Jayanth-M0625/MRL/moteus-mod-n1/moteus-mod-n1.kicad_pcb

## KiCad design moteus-mod-n1/moteus-mod-n1.kicad_pcb (2025-11-13)

Schematic: moteus-mod-n1.kicad_sch

Parts:
A1: PAD16AWG_TERM; 16AWG_TERMcustom
B1: PAD16AWG_TERM; 16AWG_TERMcustom
C1, C3, C6, C10, C33, C46, C47, C53, C64, C70, C72: 0.1uF; C0402; MPN MF-CAP-0402-0.1uF
C2: 0.47uF 100V; C0805; MPN 08051C474KAT2A
C4, C7: 0.1uF 100V; C0603; MPN GCJ188R72A104KA01D
C5, C8: 1uF; C0603; MPN C1608X7R1E105K080AE
C9: DNP; C0402
C11, C16, C21, C57: 1uF; C0402; MPN MF-CAP-0402-1uF
C12: 1uF 100V; C0805; MPN GCM21BC72A105KE36L
C13: 1uF; C0603; MPN MF-CAP-0603-1uF
C14, C17, C19: 0.1uF 100V; C1206; MPN 12061C104KAT2A
C15: 22uF; C1206; MPN GRM31CR71A226KE15L
C18: PAD16AWG_TERM; 16AWG_TERMcustom
C20: 22uF; C1206; MPN CL31B226KPHNNNE
C22, C23, C24, C25, C26, C27, C28, C29, C30, C31, C34, C35, C36, C37, C38, C39, C40, C41, C43, C44, C45, C48, C49, C50, C54, C55, C56, C58, C59, C60, C61, C62, C63, C65, C66, C67, C69, C71, C76, C77, C78, C79, C80, C81, C82, C83, C84, C85: 4.7uF 100V; C1206_NOBORDER; MPN GRJ31CC72A475KE01K
C32: 0.01uF; C0402; MPN MF-CAP-0402-0.01uF
C42, C51: 4.7uF 100V; C1206; MPN GRJ31CC72A475KE01K
C52: 4.7uF; C0603; MPN CL10A475KP8NNNC
C68: 10uF; C1206; MPN MF-CAP-1206-10uF
C73, C74, C75: 1000pF; C0402; MPN MF-CAP-0402-1nF
CAN1, CAN2, CAN3: 1X3
D1, D2, D3, D4, D5, D6, D7, D8, D9: BAT41KFILM; SODFL1608X70N; MPN BAT41KFILM
D10: MF-LED-0603-RED; LED0603
D11: MF-LED-0603-RED; LED0603; MPN MF-LED-0603-GREEN
D12: DIODE-DO214AA; DO214AA; MPN SMBJ51D-M3/I
D13, D14: PAD24AWG_PAD; 24AWG_PAD
DAC1: PAD24AWG_PAD; 24AWG_PAD
DG1: PAD24AWG_PAD; 24AWG_PAD
L1: SRN4018-220M; IND_BOURNS_SRN4018; MANUFACTURER_PART_NUMBER 74404042470
L2: 74479887222A; IND_1008_WE-PMI_WRE; MPN 74479887222A
M1, M2, M3: MOUNT; M2.5MOUNT
Q1, Q3, Q5: TPH1R204PL_VIAS; SOP_ADVANCE_8_VIAS; MPN TPH2R408QM,L1Q
Q2, Q4, Q6: TPH1R204PLSOP_ADVANCE_8; SOP_ADVANCE_8; MPN TPH2R408QM,L1Q
R1, R2: 2k; R0402; MPN MF-RES-0402-2K
R3, R8, R13: 0; R0402; MPN MF-RES-0402-0
R4, R17: DNP; R0402
R5: DNP; R0805
R6, R7, R10, R11, R12: 7.5; R0402; MPN RC0402FR-077R5L
R9: 7.5; R0805; MPN RC0805FR-077R5L
R14, R16: 100k 1%; R0402; MPN RC0402FR-07100KL
R15: 4.7k 1%; R0402; MPN RC0402FR-074K7L
R18, R21: 560; R0402; MPN MF-RES-0402-560
R19: 47k NTC; R0402; MPN NCP15WB473F03RC
R20, R22: 10k 1%; R0402; MPN RC0402FR-0710KL
R23, R24, R25: 22; R0402; MPN MF-RES-0402-22
RA1: 0.5mOhm 1% 2W; M1206; MPN HCS1206FTL500
RB1: 0.5mOhm 1% 2W; M1206; MPN HCS1206FTL500
RC1: 0.5mOhm 1% 2W; M1206; MPN HCS1206FTL500
SH1: SHORTMEDIUM; SHORT_TOP-MEDIUM
SH2, SH3, SH4: SHORTT5; SHORT_TOP-50
SWD1: JST-ZH6; JST_S6B-ZR-SM4A-TF(LF)(SN); MPN S6B-ZR-SM4A-TF(LF)(SN)
TEMP1: 1X2
U1: TCAN1042HGV; SOIC8; MPN TCAN1057AEVDRQ1
U2: AS5147; TSSOP14; MPN AS5047P-ATSM
U3: DRV8353S; WQFN-40; MPN DRV8353FSRTAR
U4: MAX15062AATA+T; 21-0487A_MXM; MANUFACTURER_PART_NUMBER MAX15062BATA+T
U5: ADP5301ACBZ-4-R7; BGA9C50P3X3_165X187X66; MPN ADP5301ACBZ-4-R7
U6: STM32G474CEU6; QFN50P700X700X60-49N; MPN STM32G474CEU6
VN1: PAD16AWG_TERM; 16AWG_TERMcustom
VP1: PAD16AWG_TERM; 16AWG_TERMcustom

Connections:
+3V3: C3.P$1, C6.P$2, C10.P$1, C20.P$1, C21.P$1, C46.P$1, C47.P$1, C52.P$1, C57.P$1, C64.P$1, C68.P$2, C70.P$1, D14.P$1, L2.1, R1.P$1, R2.P$1, R3.P$2, R16.P$2, R18.P$1, R19.P$1, R21.P$1, SWD1.6, TEMP1.1, U1.5 (VIO), U2.12 (VDD3V), U3.24 (VREF), U5.C2 (FB), U6.1 (VBAT), U6.20 (VREF+), U6.21 (VDDA), U6.23 (VDD_1), U6.35 (VDD_2), U6.48 (VDD_3)
+5V: C1.P$1, C15.P$1, C16.P$1, D13.P$1, L1.1, R13.P$2, U1.3 (VCC), U4.4 (FB/VOUT), U5.A2 (PVIN), U5.A3 (EN)
/AS5047_CS: U2.1 (CS/), U6.19 (PB2)
/AUX1_A: U2.2 (CLK), U6.13 (PA5), U6.27 (PB14)
/AUX1_B: U2.3 (MISO), U6.42 (PB4)
/AUX1_C: U2.4 (MOSI), U6.15 (PA7)
/CAN_N: CAN1.2, CAN2.2, CAN3.2, R5.P$2, U1.6 (CANL)
/CAN_P: CAN1.1, CAN2.1, CAN3.1, R5.P$1, U1.7 (CANH)
/CAN_RX: U1.4 (RXD), U6.43 (PB5)
/CAN_TX: U1.1 (TXD), U6.44 (PB6)
/CUR1: R23.P$1, U3.23 (SOA)
/CUR2: R24.P$1, U3.22 (SOB)
/CUR3: R25.P$1, U3.21 (SOC)
/DAC: DAC1.P$1, R16.P$1, R17.P$2, U6.12 (PA4)
/DRV8323_CS: U3.30 (CS), U6.17 (PB0)
/DRV8323_MISO: R1.P$2, U3.27 (MISO), U6.40 (PC11)
/DRV8323_MOSI: U3.28 (MOSI), U6.2 (PC13)
/DRV8323_SCLK: U3.29 (SCLK), U6.39 (PC10)
/FCUR1: C73.P$1, R23.P$2, U6.11 (PA3)
/FCUR2: C74.P$1, R24.P$2, U6.14 (PA6)
/FCUR3: C75.P$1, R25.P$2, U6.18 (PB1)
/GHA: D2.1 (K), R7.P$1, U3.6 (GHA)
/GHA_D: D2.2 (A), Q1.4 (G), R7.P$2
/GHB: D5.1 (K), R10.P$1, U3.15 (GHB)
/GHB_D: D5.2 (A), Q3.4 (G), R10.P$2
/GHC: D7.1 (K), R12.P$1, U3.16 (GHC)
/GHC_D: D7.2 (A), Q5.4 (G), R12.P$2
/GLA: D1.1 (K), R6.P$1, U3.8 (GLA)
/GLA_D: D1.2 (A), D3.1 (K), Q2.4 (G), R6.P$2
/GLB: D4.1 (K), R9.P$1, U3.13 (GLB)
/GLB_D: D4.2 (A), D6.1 (K), Q4.4 (G), R9.P$2
/GLC: D8.1 (K), R11.P$1, U3.18 (GLC)
/GLC_D: D8.2 (A), D9.1 (K), Q6.4 (G), R11.P$2
/LED1: D10.CATHODE, U6.28 (PB15)
/LED2: D11.CATHODE, U6.29 (PC6)
/MOTOR1: U3.32 (INHA), U6.8 (PA0)
/MOTOR2: U3.34 (INHB), U6.9 (PA1)
/MOTOR3: U3.36 (INHC), U6.10 (PA2)
/MOTOR_ENABLE: U3.31 (ENABLE), U6.3 (PC14-OSC32_IN)
/MOTOR_FAULT: R2.P$2, U3.26 (FAULT), U6.26 (PB13)
/MOTOR_HIZ: U3.33 (INLA), U3.35 (INLB), U3.37 (INLC), U6.4 (PC15-OSC32_OUT)
/NRST: C33.P$1, SWD1.2, U6.7 (PG10-NRST)
/SHA: A1.1, A1.2, A1.3, A1.4, A1.5, A1.6, A1.7, A1.8, A1.9, A1.10, A1.11, A1.12, A1.13, Q1.1 (S), Q1.2 (S), Q1.3 (S), Q2.5 (D), Q2.6 (D), Q2.7 (D), Q2.8 (D), Q2.PAD (D), U3.7 (SHA)
/SHB: B1.1, B1.2, B1.3, B1.4, B1.5, B1.6, B1.7, B1.8, B1.9, B1.10, B1.11, B1.12, B1.13, Q3.1 (S), Q3.2 (S), Q3.3 (S), Q4.5 (D), Q4.6 (D), Q4.7 (D), Q4.8 (D), Q4.PAD (D), U3.14 (SHB)
/SHC: C18.1, C18.2, C18.3, C18.4, C18.5, C18.6, C18.7, C18.8, C18.9, C18.10, C18.11, C18.12, C18.13, Q5.1 (S), Q5.2 (S), Q5.3 (S), Q6.5 (D), Q6.6 (D), Q6.7 (D), Q6.8 (D), Q6.PAD (D), U3.17 (SHC)
/SWCLK: SWD1.5, U6.37 (PA14)
/SWDIO: SWD1.3, U6.36 (PA13)
/SXA_N: SH2.1, U3.10 (SNA)
/SXA_P: C14.P$2, Q2.1 (S), Q2.2 (S), Q2.3 (S), RA1.2, U3.9 (SPA)
/SXB_N: SH3.1, U3.11 (SNB)
/SXB_P: C17.P$2, Q4.1 (S), Q4.2 (S), Q4.3 (S), RB1.2, U3.12 (SPB)
/SXC_N: SH4.1, U3.20 (SNC)
/SXC_P: C19.P$2, Q6.1 (S), Q6.2 (S), Q6.3 (S), RC1.2, U3.19 (SPC)
/VBAT_SENSE: C32.P$1, R14.P$1, R15.P$2, U6.31 (PA9)
/VSW: L1.2, U4.8 (LX)
/VTEMP_FET: C53.P$1, R19.P$2, R20.P$1, U6.25 (PB12)
/VTEMP_MOT: C72.P$1, R22.P$1, TEMP1.2, U6.30 (PA8)
unnamed: C9.P$1, M3.P$1, R4.P$1
unnamed: D10.ANODE, R18.P$2
unnamed: D11.ANODE, R21.P$2
unnamed: R3.P$1, U2.11 (VDD5V)
unnamed: C7.P$1, U3.2 (CPH)
unnamed: C7.P$2, U3.1 (CPL)
unnamed: C11.P$2, U3.38 (DVDD)
unnamed: C5.P$2, U3.5 (VCP)
unnamed: C8.P$2, U3.40 (VGLS)
unnamed: R8.P$2, U4.5 (MODE)
unnamed: C13.P$1, U4.3 (VCC)
unnamed: L2.2, U5.A1 (SW)
unnamed: R13.P$1, U5.B3 (SYNC/_MODE)
V+: C2.P$1, C4.P$1, C5.P$1, C12.P$1, C14.P$1, C17.P$1, C19.P$1, C22.P$1, C23.P$1, C24.P$1, C25.P$1, C26.P$1, C27.P$1, C28.P$1, C29.P$1, C30.P$1, C31.P$1, C34.P$1, C35.P$1, C36.P$1, C37.P$1, C38.P$1, C39.P$1, C40.P$1, C41.P$1, C42.P$1, C43.P$1, C44.P$1, C45.P$1, C48.P$1, C49.P$1, C50.P$1, C51.P$1, C54.P$1, C55.P$1, C56.P$1, C58.P$1, C59.P$1, C60.P$1, C61.P$1, C62.P$1, C63.P$1, C65.P$1, C66.P$1, C67.P$1, C69.P$1, C71.P$1, C76.P$1, C77.P$1, C78.P$1, C79.P$1, C80.P$1, C81.P$1, C82.P$1, C83.P$1, C84.P$1, C85.P$1, D12.C, Q1.5 (D), Q1.6 (D), Q1.7 (D), Q1.8 (D), Q1.PAD (D), Q3.5 (D), Q3.6 (D), Q3.7 (D), Q3.8 (D), Q3.PAD (D), Q5.5 (D), Q5.6 (D), Q5.7 (D), Q5.8 (D), Q5.PAD (D), R14.P$2, U3.3 (VM), U3.4 (VDRAIN), U4.1 (VIN), U4.2 (EN/UVLO), VP1.1, VP1.2, VP1.3, VP1.4, VP1.5, VP1.6, VP1.7, VP1.8, VP1.9, VP1.10, VP1.11, VP1.12, VP1.13

Notes on the sheet:
check component placement
POWER INPUT AND MOUNTING
CAN_L = CAN_N
OPTIONAL 120 TERMINATION RESISTOR
Need to connect either PA5 or PB14. Decide which one
BULK DC CAPS
MICROCONTROLLER
CAN_H = CAN_P
POWER STAGE
GATE DRIVER
Added 10 more DC Caps
NTC: Temperature sensing - keep near MOSFETs
Rotary encoder
This is where GND and V- are shorted
check how to connect this
CAN / ENCODER
check placement
This stage converts V+ into 5V and 3.3V
DEBUG
EXTERNAL CONNECTORS
PCB rev divider HI / LO r1.1/r1.2 - open / 100k r1.3 - 100k / open
REGULATORS
SENSE / LED

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
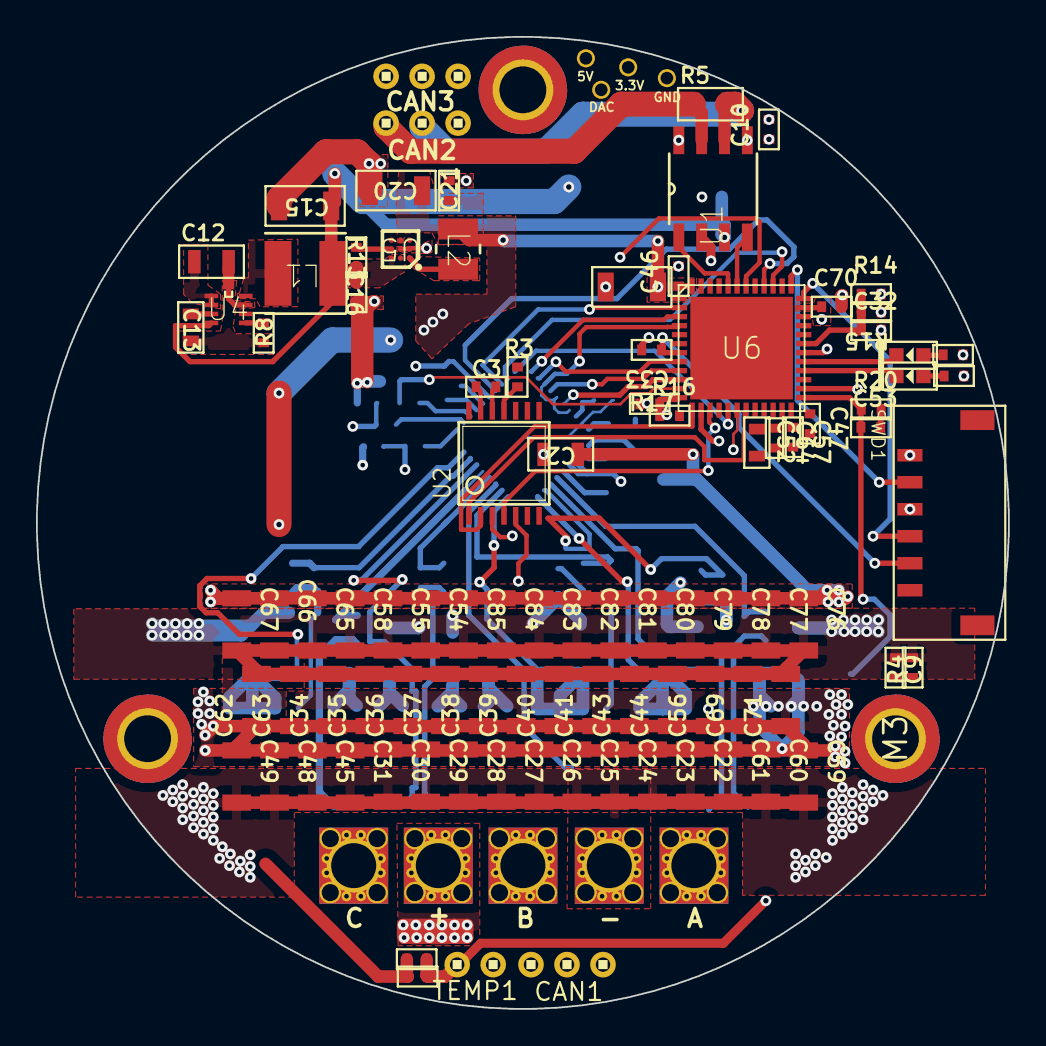
[picture p1: board moteus-mod-n1.kicad_pcb from above]

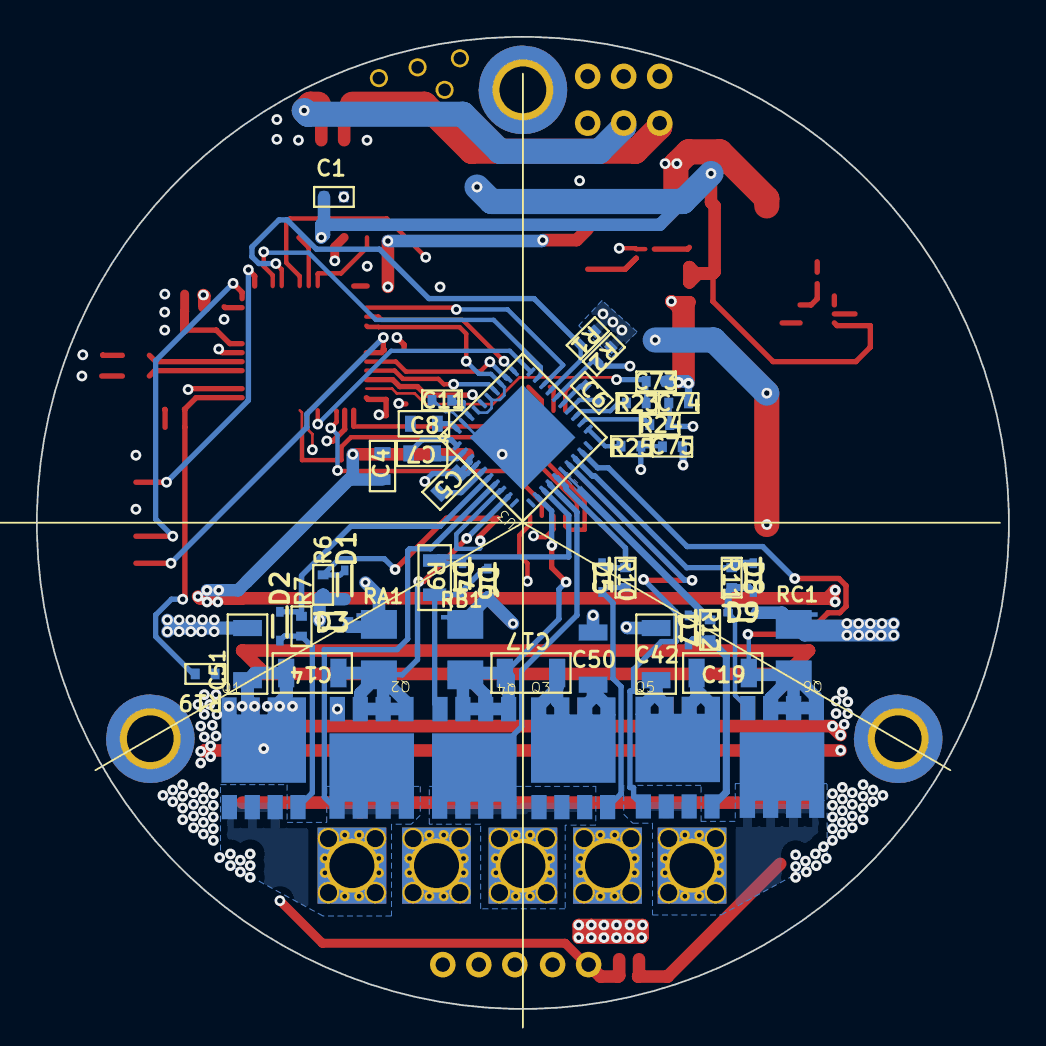
[picture p2: board moteus-mod-n1.kicad_pcb from below]

Board: 4 copper layers, 54.0 x 54.0 mm, 158 parts (50 on the bottom side), 73 nets.
