Jayanth-M0625/MRL/stm32g474/stm32g474.kicad_pcb

## KiCad design stm32g474/stm32g474.kicad_pcb (2025-10-17)

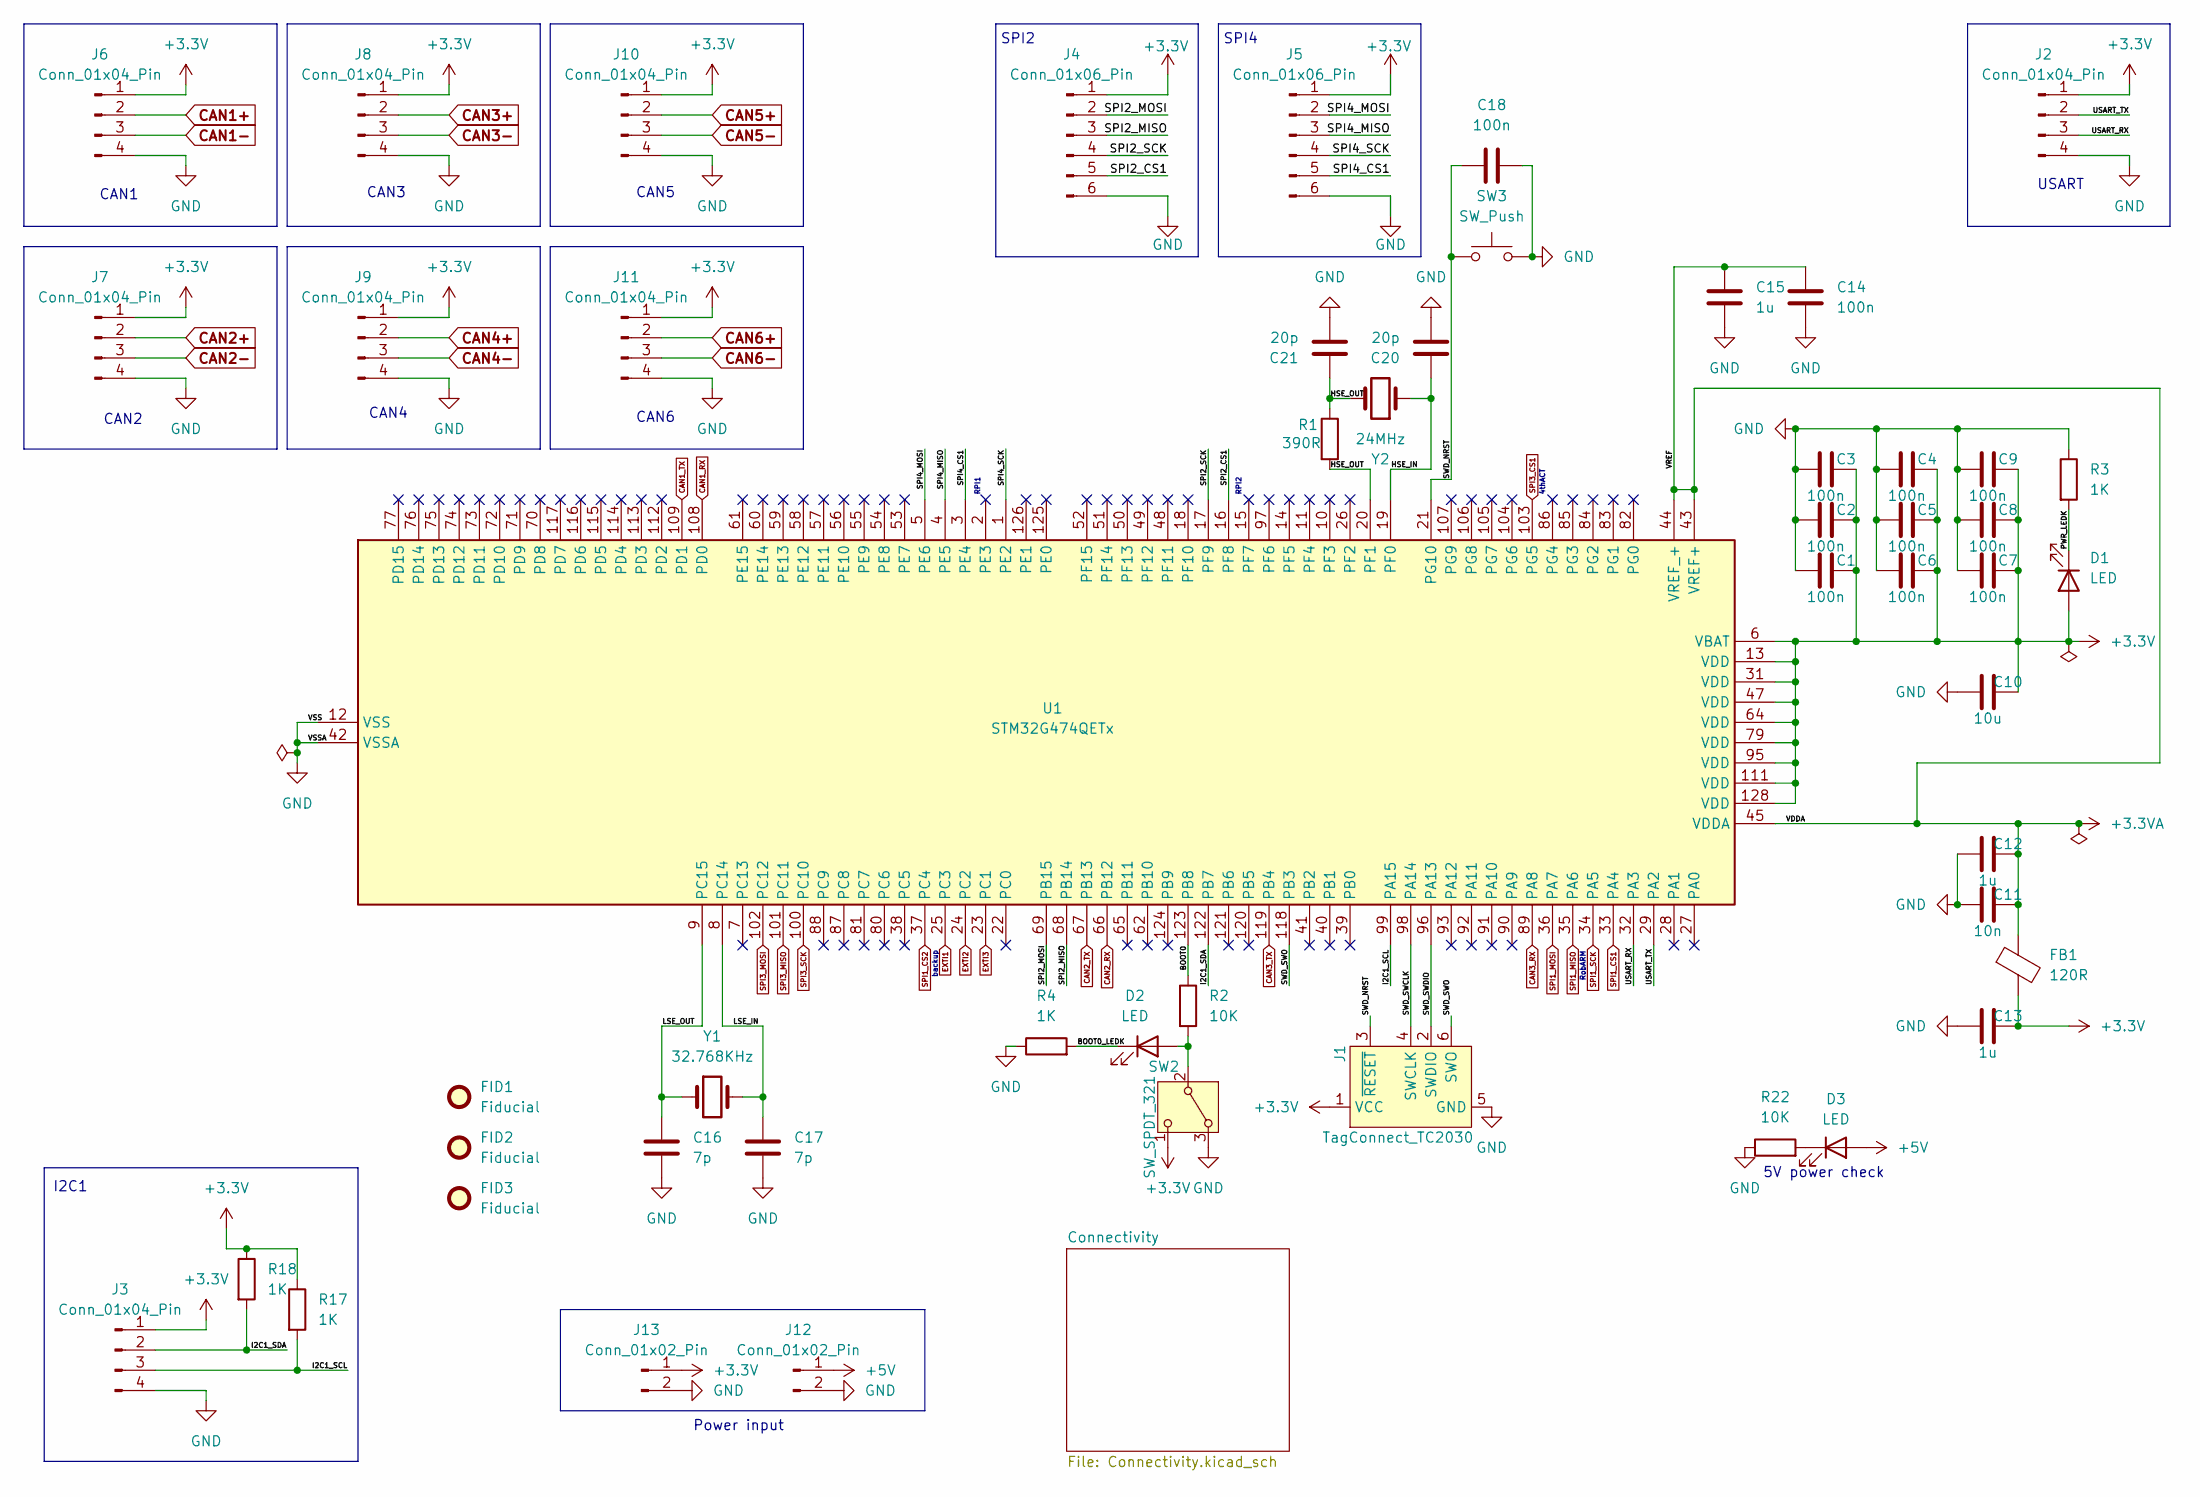
[picture p3: schematic stm32g474.kicad_sch]

Parts:
C1, C2, C3, C4, C5, C6, C7, C8, C9, C14, C18: 100n; C_0402_1005Metric; Manufacturer Part Number 0402ZC104MAT2A
C10: 10u; C_0805_2012Metric; Manufacturer Part Number C0805C106K8PAC
C11: 10n; C_0402_1005Metric
C12, C13, C15: 1u; C_0402_1005Metric
C16, C17: 7p; C_0402_1005Metric
C20, C21: 20p; C_0402_1005Metric
D1, D2, D3: LED; LED_0402_1005Metric
FB1: 120R; L_0603_1608Metric
FID1, FID2, FID3: Fiducial; Fiducial_0.5mm_Mask1.5mm
J1: TagConnect_TC2030; Tag-Connect_TC2030-IDC-FP_2x03_P1.27mm_Vertical
J2, J3, J6, J7, J8, J9, J10, J11: Conn_01x04_Pin; PinHeader_1x04_P2.54mm_Vertical
J4, J5: Conn_01x06_Pin; PinHeader_1x06_P2.54mm_Horizontal
J12, J13: Conn_01x02_Pin; PinHeader_1x02_P2.54mm_Vertical
R1: 390R; R_0402_1005Metric
R2, R22: 10K; R_0402_1005Metric
R3, R4, R17, R18: 1K; R_0402_1005Metric
SW2: SW_SPDT_321; SW_SPDT_PCM12
SW3: SW_Push; SW_SPST_CK_RS282G05A3
U1: STM32G474QETx; LQFP-128_14x14mm_P0.4mm
Y1: 32.768KHz; Crystal_SMD_3215-2Pin_3.2x1.5mm; Manufacturer Part Number CM7V-T1A-32.768kHz-7pF-10PPM-TA-QC T3
Y2: 24MHz; Crystal_SMD_TXC_7M-4Pin_3.2x2.5mm; Manufacturer Part Number ECS-240-20-33-CKM-TR3

Connections:
+3.3V: C1.1, C2.1, C3.1, C4.1, C5.1, C6.1, C7.1, C8.1, C9.1, C10.1, C13.1, D1.2 (A), FB1.2, J1.1 (VCC), J2.1, J3.1, J4.1, J5.1, J6.1, J7.1, J8.1, J9.1, J10.1, J11.1, J13.1, R17.1, R18.1, SW2.1 (C), U1.6 (VBAT), U1.13 (VDD), U1.31 (VDD), U1.47 (VDD), U1.64 (VDD), U1.79 (VDD), U1.95 (VDD), U1.111 (VDD), U1.128 (VDD); also elsewhere on the board
+3.3VA: C11.1, C12.1, C14.1, C15.1, FB1.1, U1.43 (VREF+), U1.44 (VREF_+), U1.45 (VDDA)
/BOOT0: R2.1, U1.123 (PB8)
/BOOT0_LEDK: D2.1 (K), R4.2
/HSE_IN: C20.1, U1.19 (PF0), Y2.1
/HSE_OUT: C21.1, R1.1, R1.2, U1.20 (PF1), Y2.2
/I2C1_SCL: J3.3, R17.2, U1.99 (PA15)
/I2C1_SDA: J3.2, R18.2, U1.122 (PB7)
/LSE_IN: C17.1, U1.8 (PC14), Y1.2
/LSE_OUT: C16.1, U1.9 (PC15), Y1.1
/PWR_LEDK: D1.1 (K), R3.2
/SPI2_CS1: J4.5, U1.16 (PF8)
/SPI2_MISO: J4.3, U1.68 (PB14)
/SPI2_MOSI: J4.2, U1.69 (PB15)
/SPI2_SCK: J4.4, U1.17 (PF9)
/SPI4_CS1: J5.5, U1.3 (PE4)
/SPI4_MISO: J5.3, U1.4 (PE5)
/SPI4_MOSI: J5.2, U1.5 (PE6)
/SPI4_SCK: J5.4, U1.1 (PE2)
/SWD_NRST: C18.2, J1.3 (~RESET), SW3.1, U1.21 (PG10)
/SWD_SWCLK: J1.4 (SWCLK), U1.98 (PA14)
/SWD_SWDIO: J1.2 (SWDIO), U1.96 (PA13)
/SWD_SWO: J1.6 (SWO), U1.118 (PB3)
/USART_RX: J2.3, U1.32 (PA3)
/USART_TX: J2.2, U1.29 (PA2)
CAN1+: J6.2; also elsewhere on the board
CAN1-: J6.3; also elsewhere on the board
CAN1_RX: U1.108 (PD0); also elsewhere on the board
CAN1_TX: U1.109 (PD1); also elsewhere on the board
CAN2+: J7.2; also elsewhere on the board
CAN2-: J7.3; also elsewhere on the board
CAN2_RX: U1.66 (PB12); also elsewhere on the board
CAN2_TX: U1.67 (PB13); also elsewhere on the board
CAN3+: J8.2; also elsewhere on the board
CAN3-: J8.3; also elsewhere on the board
CAN3_RX: U1.89 (PA8); also elsewhere on the board
CAN3_TX: U1.119 (PB4); also elsewhere on the board
CAN4+: J9.2; also elsewhere on the board
CAN4-: J9.3; also elsewhere on the board
CAN5+: J10.2; also elsewhere on the board
CAN5-: J10.3; also elsewhere on the board
CAN6+: J11.2; also elsewhere on the board
CAN6-: J11.3; also elsewhere on the board
EXTI1: U1.25 (PC3); also elsewhere on the board
EXTI2: U1.24 (PC2); also elsewhere on the board
EXTI3: U1.23 (PC1); also elsewhere on the board
GND: C1.2, C2.2, C3.2, C4.2, C5.2, C6.2, C7.2, C8.2, C9.2, C10.2, C11.2, C12.2, C13.2, C14.2, C15.2, C16.2, C17.2, C18.1, C20.2, C21.2, J1.5 (GND), J2.4, J3.4, J4.6, J5.6, J6.4, J7.4, J8.4, J9.4, J10.4, J11.4, J12.2, J13.2, R3.1, R4.1, R22.1, SW2.3 (A), SW3.2, U1.12 (VSS), U1.30 (VSS), U1.42 (VSSA), U1.46 (VSS), U1.63 (VSS), U1.78 (VSS), U1.94 (VSS), U1.110 (VSS), U1.127 (VSS); also elsewhere on the board
unnamed: D2.2 (A), R2.2, SW2.2 (B)
SPI1_CS1: U1.33 (PA4); also elsewhere on the board
SPI1_CS2: U1.37 (PC4); also elsewhere on the board
SPI1_MISO: U1.35 (PA6); also elsewhere on the board
SPI1_MOSI: U1.36 (PA7); also elsewhere on the board
SPI1_SCK: U1.34 (PA5); also elsewhere on the board
SPI3_CS1: U1.103 (PG5); also elsewhere on the board
SPI3_MISO: U1.101 (PC11); also elsewhere on the board
SPI3_MOSI: U1.102 (PC12); also elsewhere on the board
SPI3_SCK: U1.100 (PC10); also elsewhere on the board

Notes on the sheet:
SPI2
CAN2
RobARM
USART
CAN1
5V power check
RPI1
backup
CAN6
SPI4
4thACT
CAN5
Power input
CAN3
I2C1
RPI2
CAN4

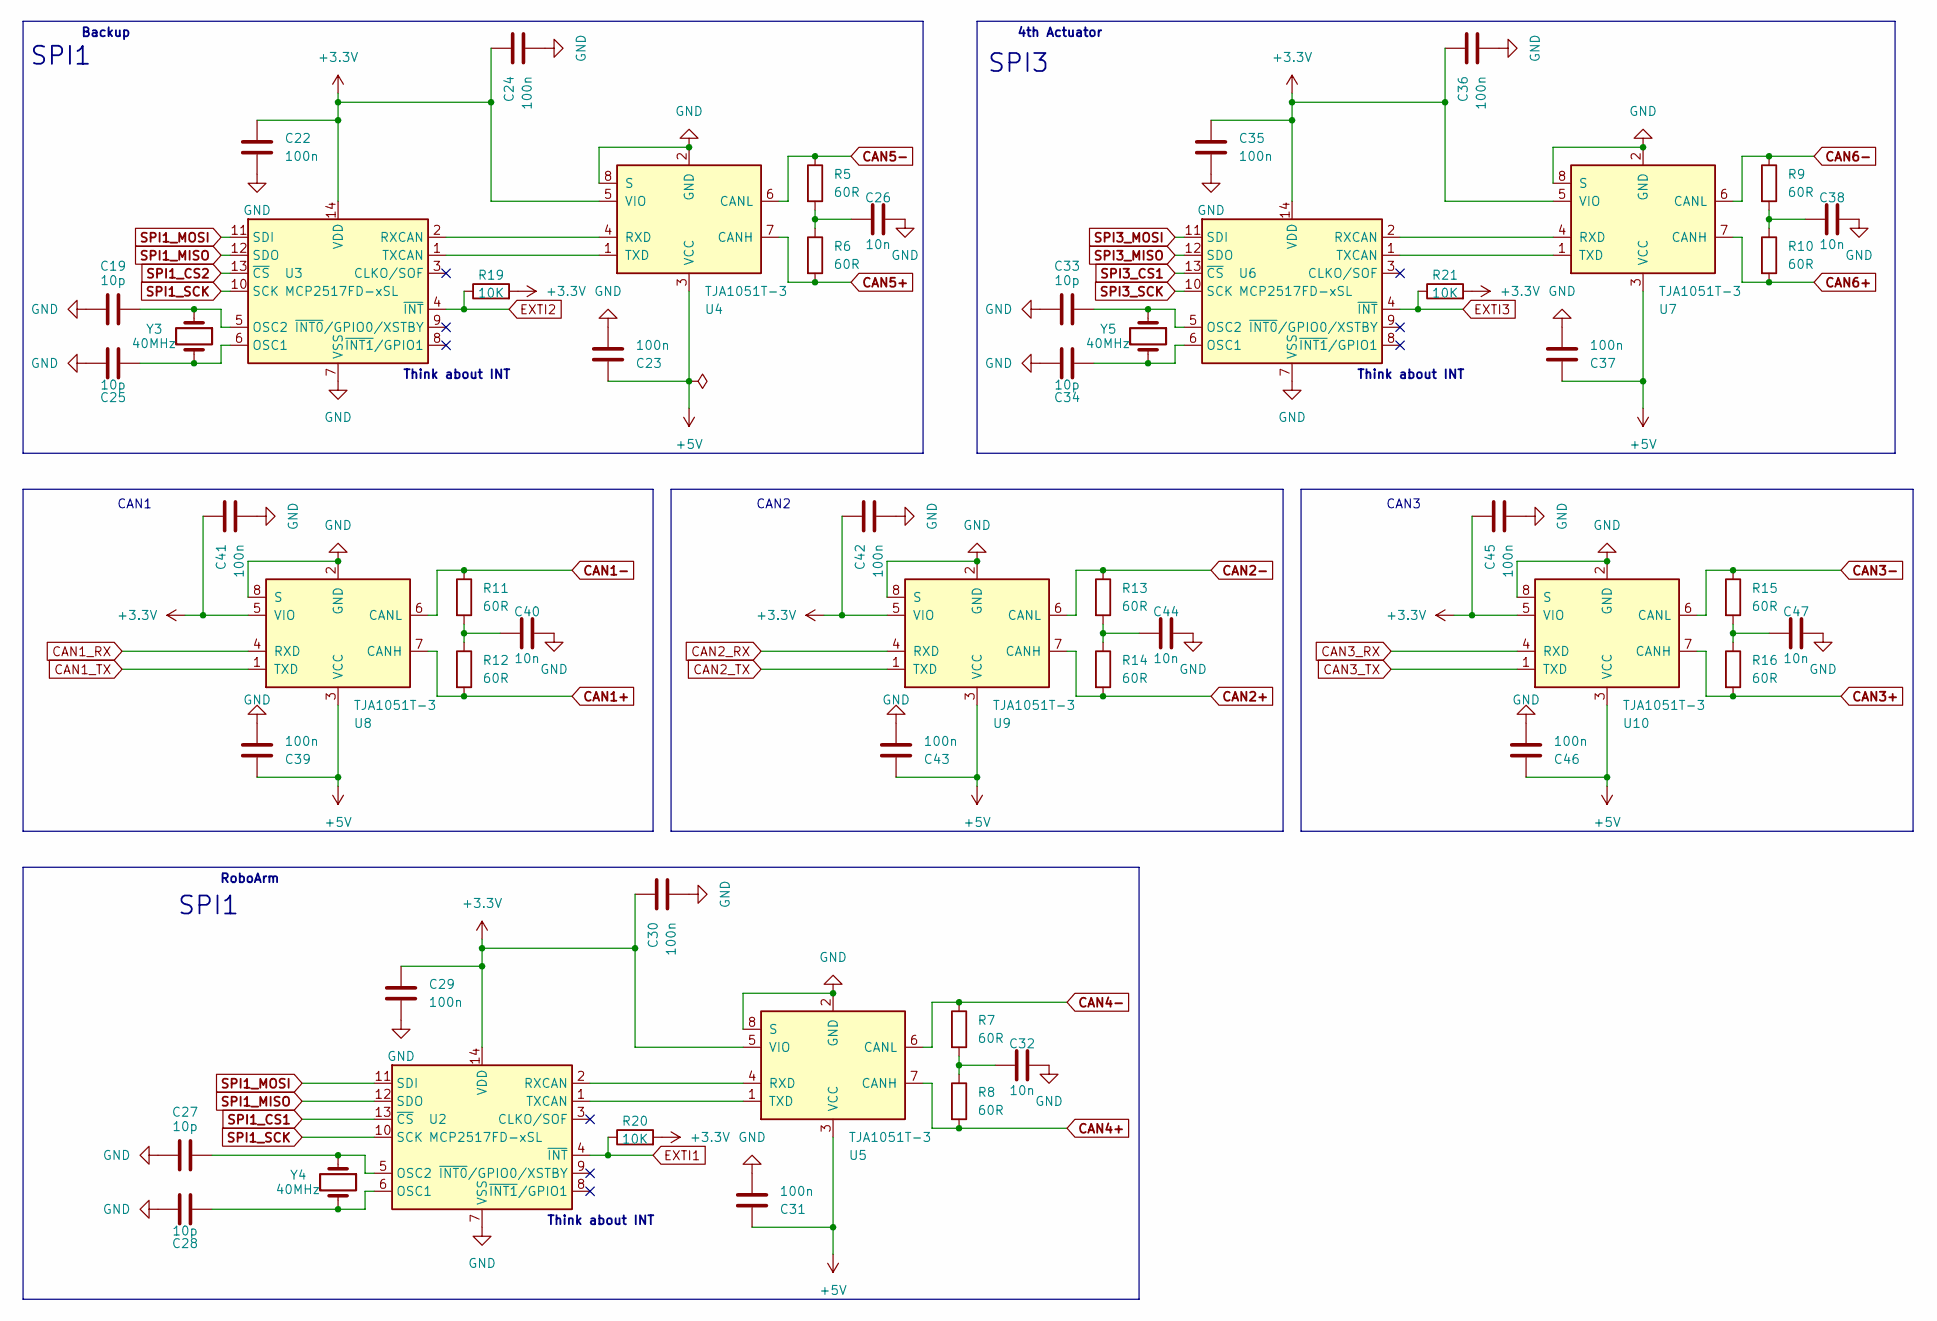
[picture p4: schematic Connectivity.kicad_sch]

Parts:
C19, C25, C27, C28, C33, C34: 10p; C_0402_1005Metric
C22, C23, C24, C29, C30, C31, C35, C36, C37, C39, C41, C42, C43, C45, C46: 100n; C_0402_1005Metric; Manufacturer Part Number 0402ZC104MAT2A
C26, C32, C38, C40, C44, C47: 10n; C_0402_1005Metric
R5, R6, R7, R8, R9, R10, R11, R12, R13, R14, R15, R16: 60R; R_0402_1005Metric
R19, R20, R21: 10K; R_0402_1005Metric
U2, U3, U6: MCP2517FD-xSL; SOIC-14_3.9x8.7mm_P1.27mm
U4, U5, U7, U8, U9, U10: TJA1051T-3; SOIC-8_3.9x4.9mm_P1.27mm
Y3, Y4, Y5: 40MHz; Crystal_SMD_TXC_7M-4Pin_3.2x2.5mm; Manufacturer Part Number CX3225FB40000F0FZZH1

Connections:
+3.3V: C22.1, C24.1, C29.1, C30.1, C35.1, C36.1, C41.1, C42.1, C45.1, R19.2, R20.2, R21.2, U2.14 (VDD), U3.14 (VDD), U4.5 (VIO), U5.5 (VIO), U6.14 (VDD), U7.5 (VIO), U8.5 (VIO), U9.5 (VIO), U10.5 (VIO); also elsewhere on the board
CAN1+: R12.2, U8.7 (CANH); also elsewhere on the board
CAN1-: R11.1, U8.6 (CANL); also elsewhere on the board
CAN1_RX: U8.4 (RXD); also elsewhere on the board
CAN1_TX: U8.1 (TXD); also elsewhere on the board
CAN2+: R14.2, U9.7 (CANH); also elsewhere on the board
CAN2-: R13.1, U9.6 (CANL); also elsewhere on the board
CAN2_RX: U9.4 (RXD); also elsewhere on the board
CAN2_TX: U9.1 (TXD); also elsewhere on the board
CAN3+: R16.2, U10.7 (CANH); also elsewhere on the board
CAN3-: R15.1, U10.6 (CANL); also elsewhere on the board
CAN3_RX: U10.4 (RXD); also elsewhere on the board
CAN3_TX: U10.1 (TXD); also elsewhere on the board
CAN4+: R8.2, U5.7 (CANH); also elsewhere on the board
CAN4-: R7.1, U5.6 (CANL); also elsewhere on the board
CAN5+: R6.2, U4.7 (CANH); also elsewhere on the board
CAN5-: R5.1, U4.6 (CANL); also elsewhere on the board
CAN6+: R10.2, U7.7 (CANH); also elsewhere on the board
CAN6-: R9.1, U7.6 (CANL); also elsewhere on the board
EXTI1: R20.1, U2.4 (~INT); also elsewhere on the board
EXTI2: R19.1, U3.4 (~INT); also elsewhere on the board
EXTI3: R21.1, U6.4 (~INT); also elsewhere on the board
GND: C19.1, C22.2, C23.2, C24.2, C25.1, C26.2, C27.1, C28.1, C29.2, C30.2, C31.2, C32.2, C33.1, C34.1, C35.2, C36.2, C37.2, C38.2, C39.2, C40.2, C41.2, C42.2, C43.2, C44.2, C45.2, C46.2, C47.2, U2.7 (VSS), U3.7 (VSS), U4.2 (GND), U4.8 (S), U5.2 (GND), U5.8 (S), U6.7 (VSS), U7.2 (GND), U7.8 (S), U8.2 (GND), U8.8 (S), U9.2 (GND), U9.8 (S), U10.2 (GND), U10.8 (S); also elsewhere on the board
unnamed: C26.1, R5.2, R6.1
unnamed: C32.1, R7.2, R8.1
unnamed: C38.1, R9.2, R10.1
unnamed: C40.1, R11.2, R12.1
unnamed: C44.1, R13.2, R14.1
unnamed: C47.1, R15.2, R16.1
unnamed: C28.2, U2.6 (OSC1), Y4.2
unnamed: C27.2, U2.5 (OSC2), Y4.1
unnamed: U2.2 (RXCAN), U5.4 (RXD)
unnamed: U2.1 (TXCAN), U5.1 (TXD)
unnamed: C25.2, U3.6 (OSC1), Y3.2
unnamed: C19.2, U3.5 (OSC2), Y3.1
unnamed: U3.2 (RXCAN), U4.4 (RXD)
unnamed: U3.1 (TXCAN), U4.1 (TXD)
unnamed: C34.2, U6.6 (OSC1), Y5.2
unnamed: C33.2, U6.5 (OSC2), Y5.1
unnamed: U6.2 (RXCAN), U7.4 (RXD)
unnamed: U6.1 (TXCAN), U7.1 (TXD)
SPI1_CS1: U2.13 (~CS); also elsewhere on the board
SPI1_CS2: U3.13 (~CS); also elsewhere on the board
SPI1_MISO: U2.12 (SDO), U3.12 (SDO); also elsewhere on the board
SPI1_MOSI: U2.11 (SDI), U3.11 (SDI); also elsewhere on the board
SPI1_SCK: U2.10 (SCK), U3.10 (SCK); also elsewhere on the board
SPI3_CS1: U6.13 (~CS); also elsewhere on the board
SPI3_MISO: U6.12 (SDO); also elsewhere on the board
SPI3_MOSI: U6.11 (SDI); also elsewhere on the board
SPI3_SCK: U6.10 (SCK); also elsewhere on the board

Notes on the sheet:
SPI1
Think about INT
Backup
SPI3
4th Actuator
CAN3
RoboArm
CAN1
CAN2

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
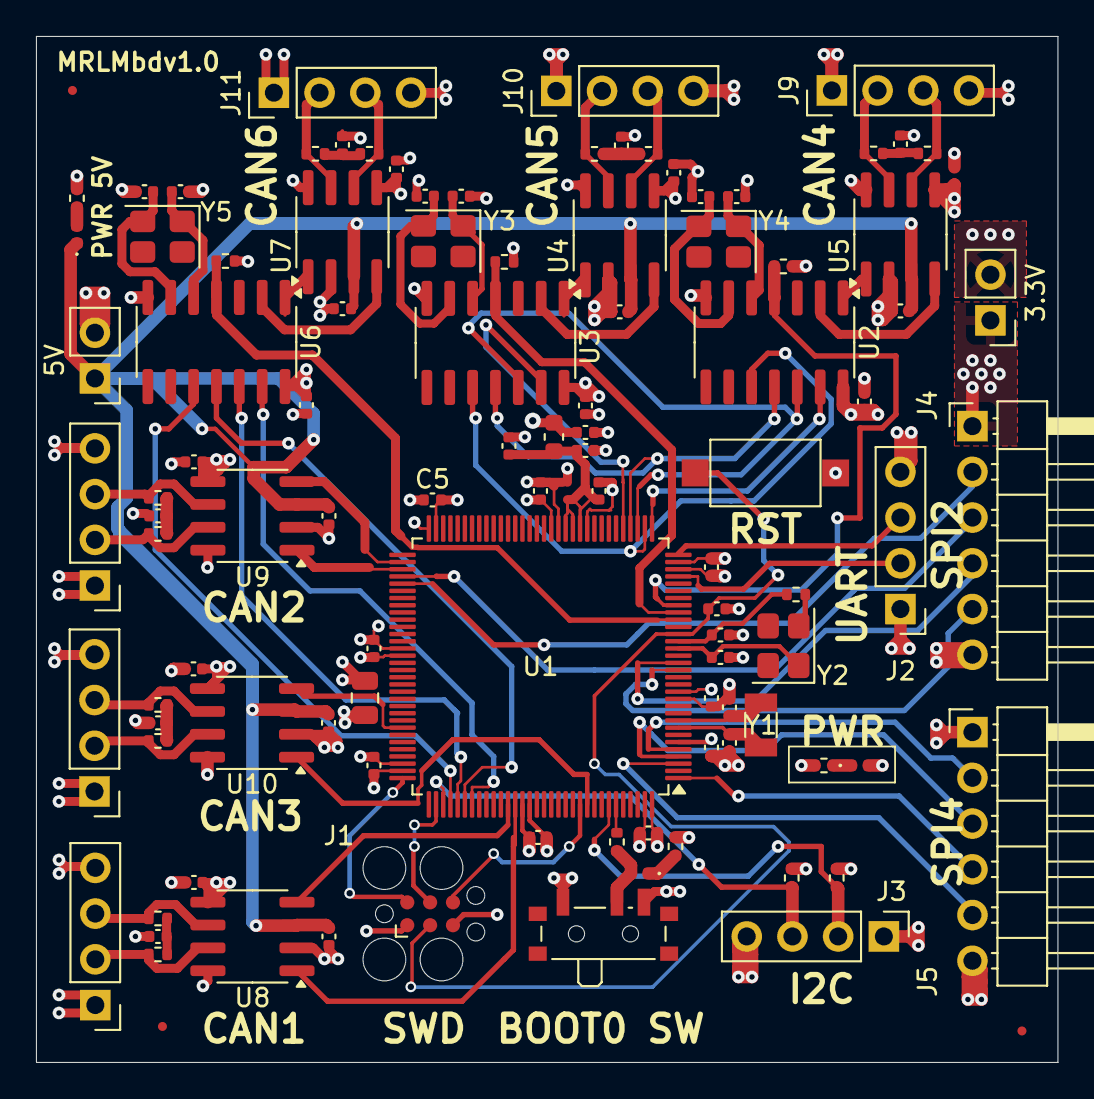
[picture p5: board stm32g474.kicad_pcb from above]

Board: 4 copper layers, 56.8 x 57.0 mm, 104 parts (0 on the bottom side), 77 nets.

Other parts of the board:
3.3V, 5V: Conn_01x02_Pin; PinHeader_1x02_P2.54mm_Vertical

Their connections:
+3.3V: 3.3V.1; also elsewhere on the board
GND: 3.3V.2, 5V.2; also elsewhere on the board
