Jayanth-M0625/MRL/(commit log)

2025-09-26 Added schematic
    [Connectivity.kicad_sch, More_Conn1.kicad_sch, stm32g474.kicad_pcb, stm32g474.kicad_sch]
2025-10-05 pcb update
    [More_Conn1.kicad_sch, stm32g474.kicad_pcb, stm32g474.kicad_sch]
